chaithr45/tt-eeg-afe/design/docs/sheet1.png

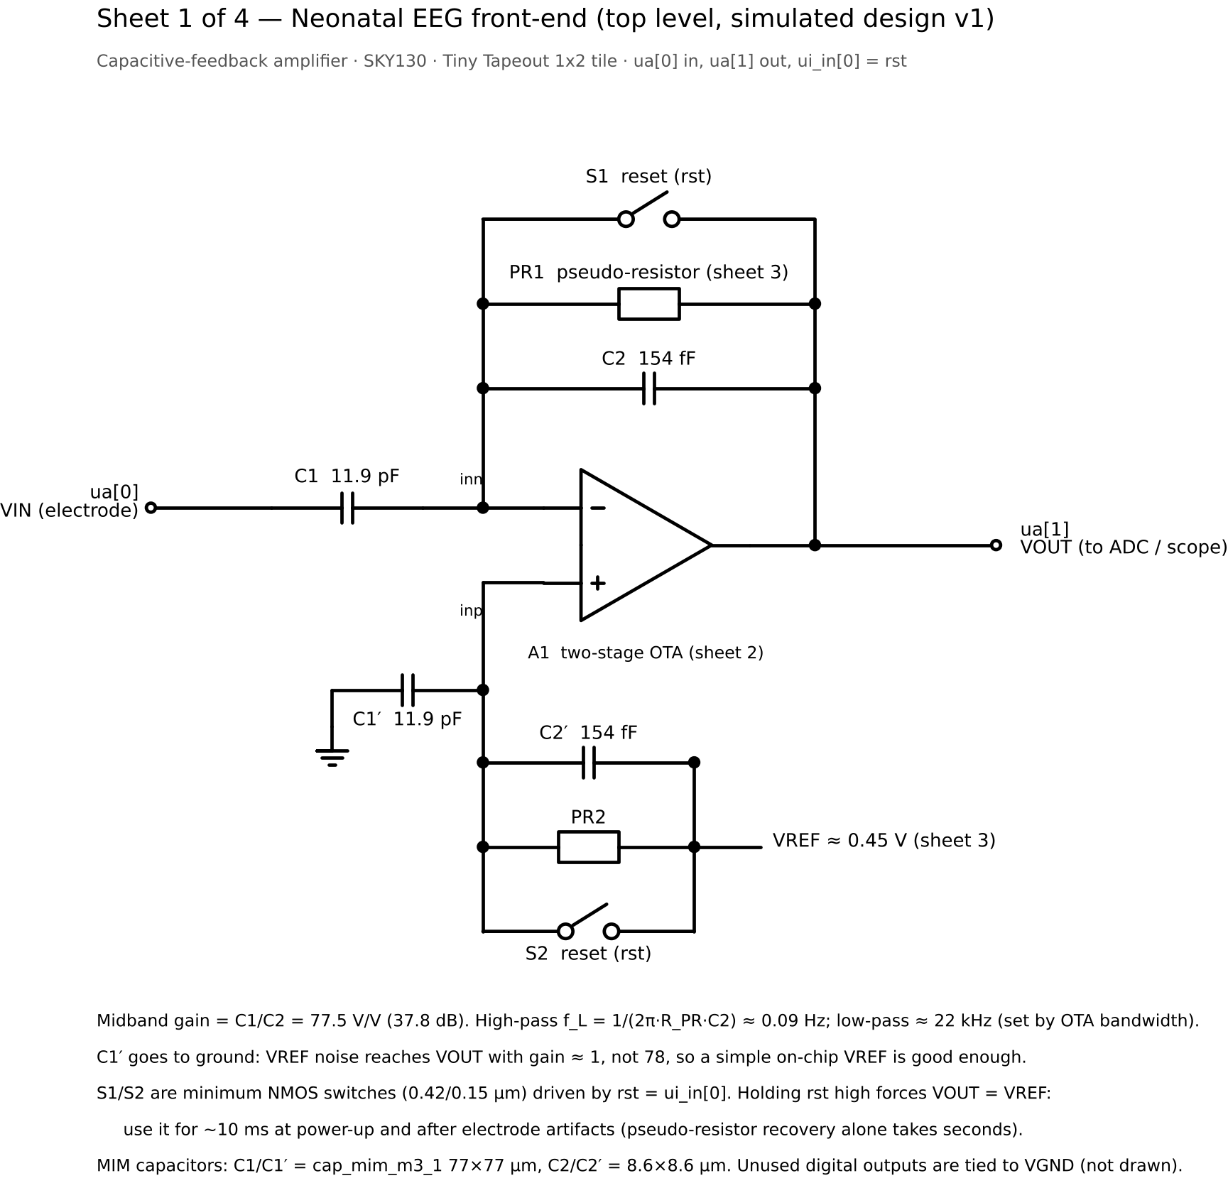
design/docs/sheet1.png
