chaithr45/tt-eeg-afe/design/docs/sheet2.png

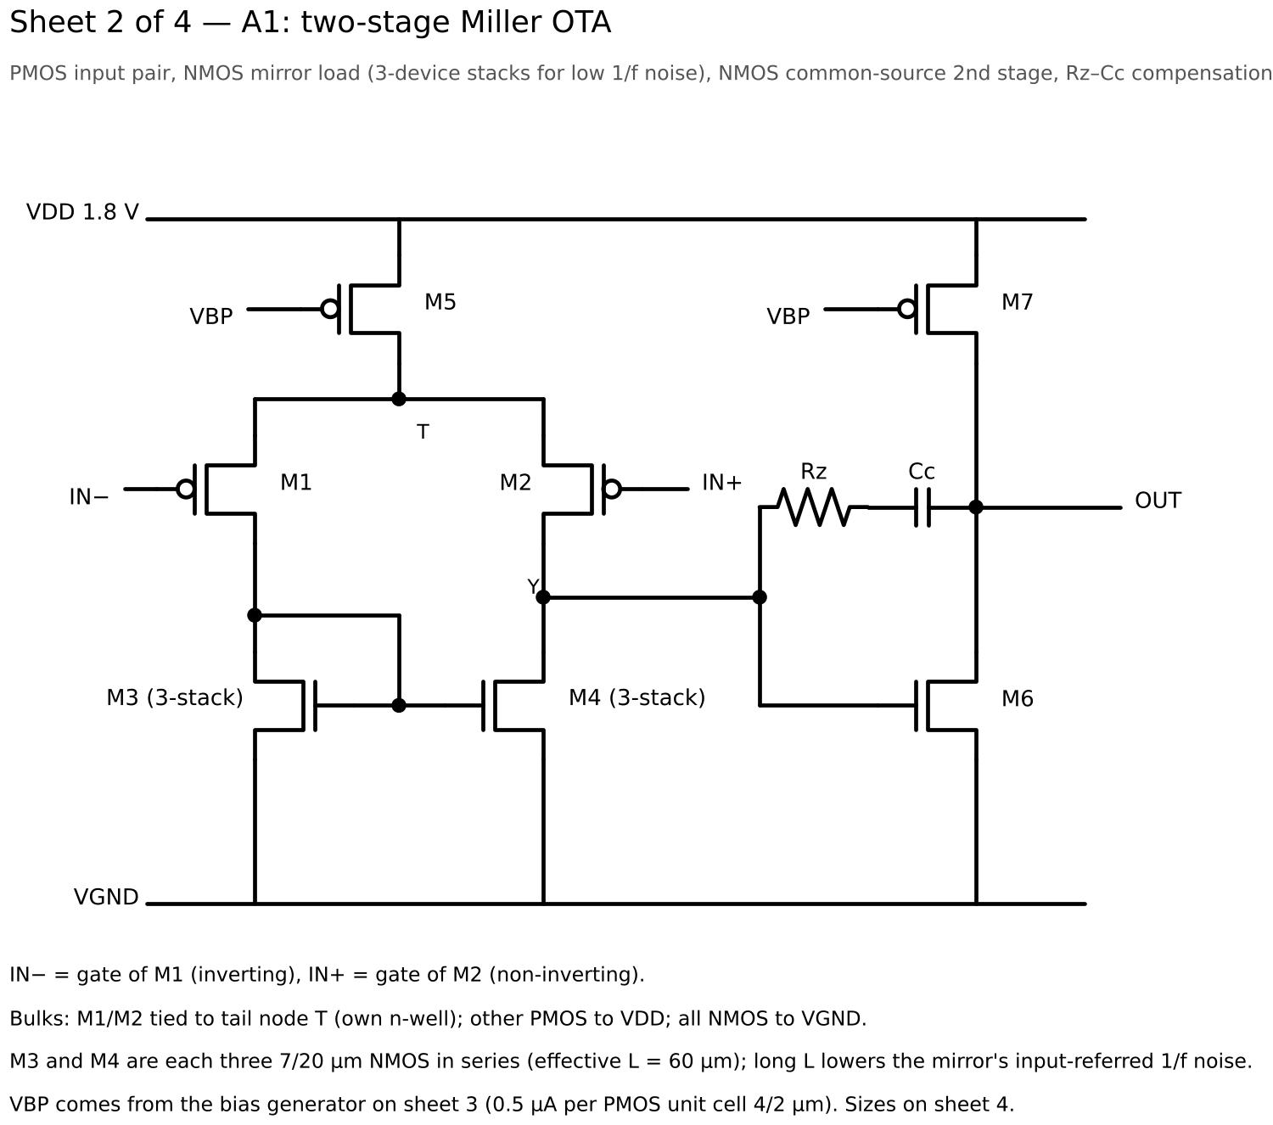
design/docs/sheet2.png
