chaithr45/tt-eeg-afe/design/docs/sheet3.png

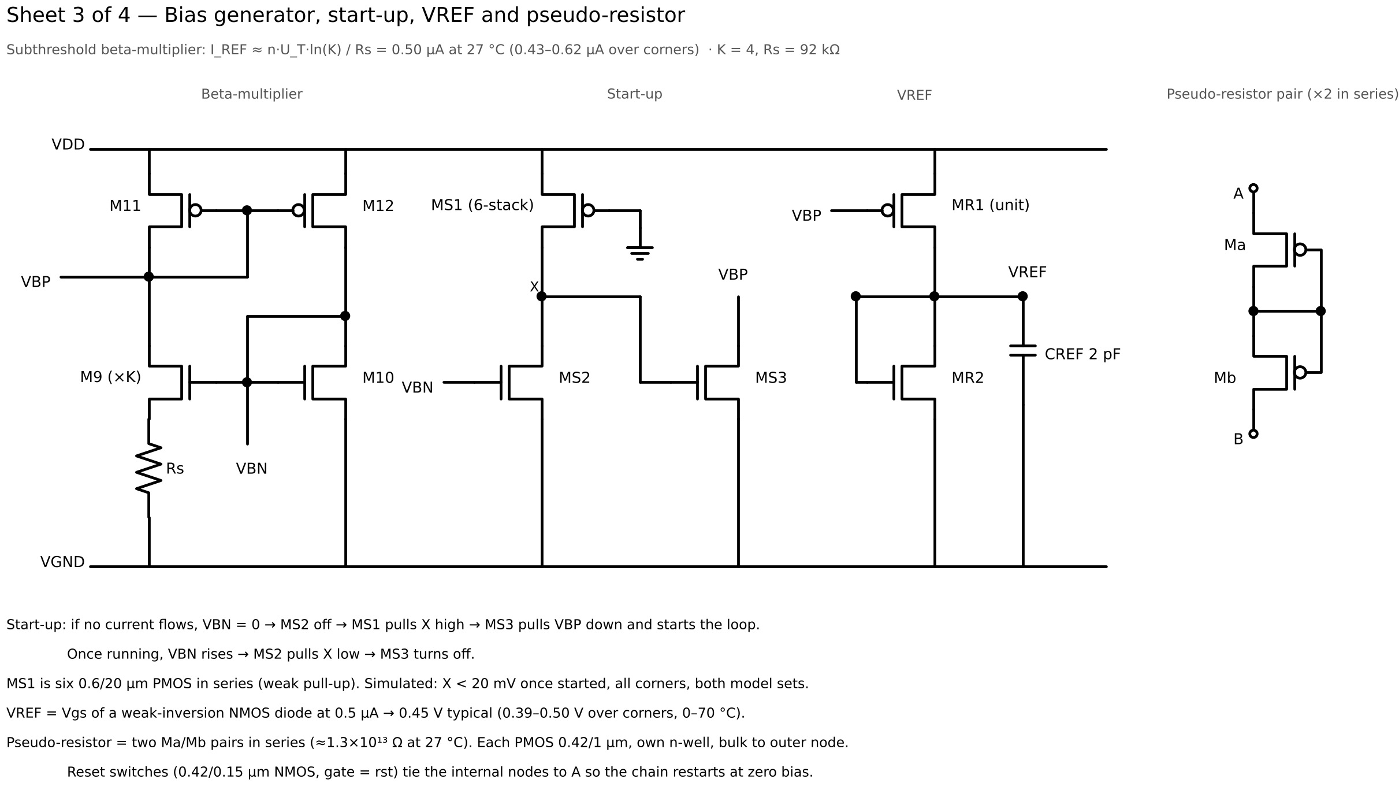
design/docs/sheet3.png
