chaithr45/tt-eeg-afe/design/docs/sheet4.png

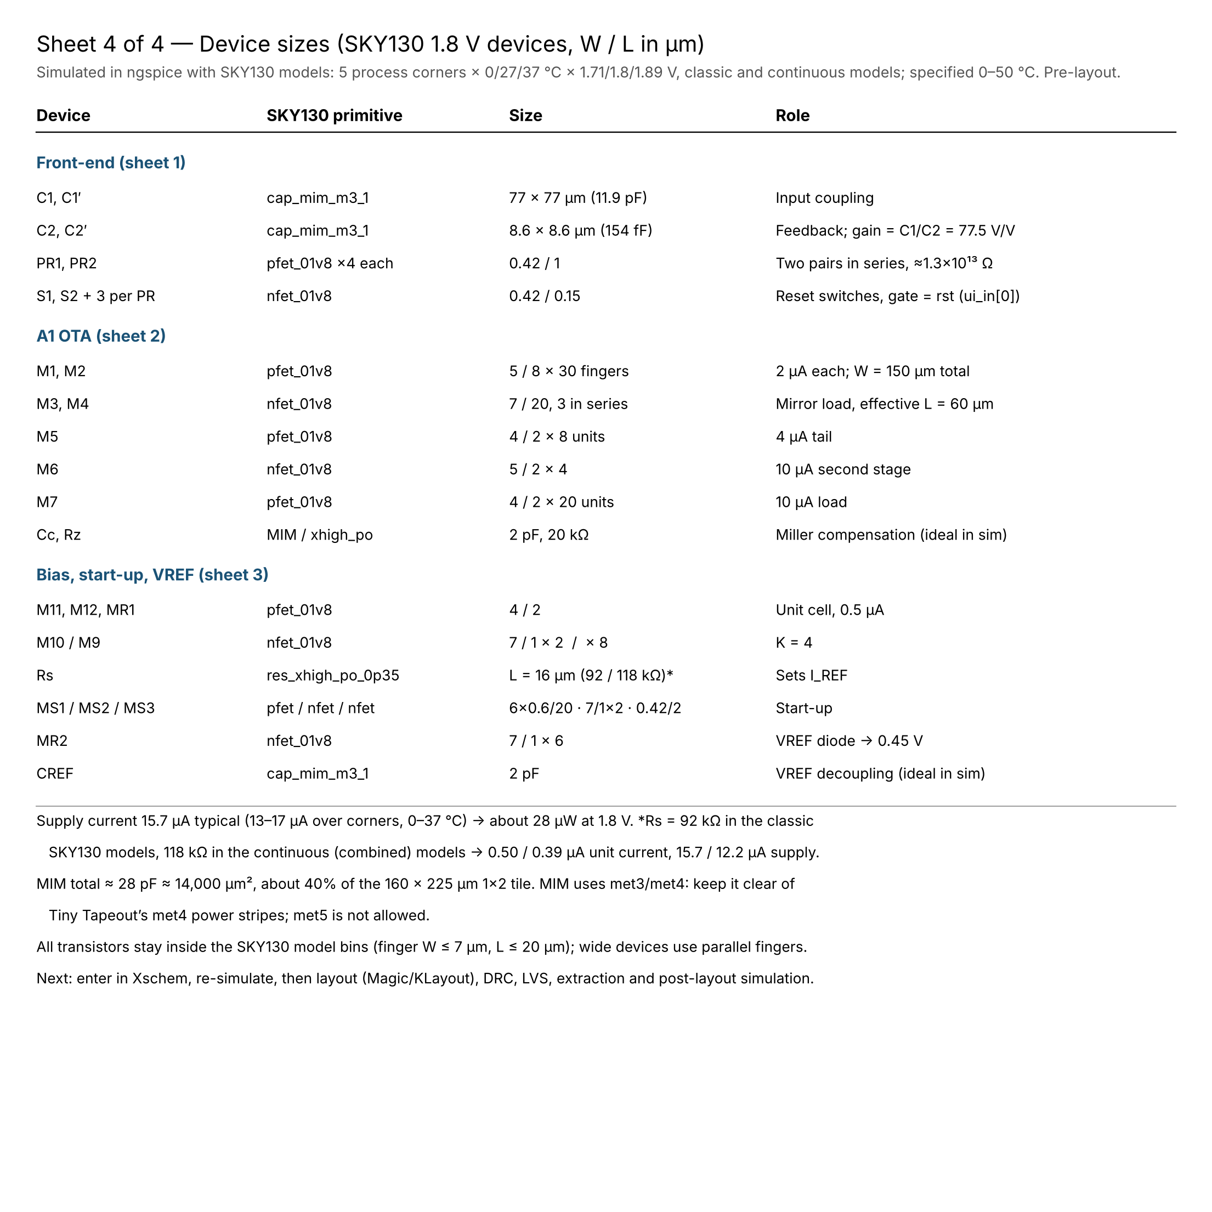
design/docs/sheet4.png
