chaithr45/tt-eeg-afe/design/xschem/img/afe.png

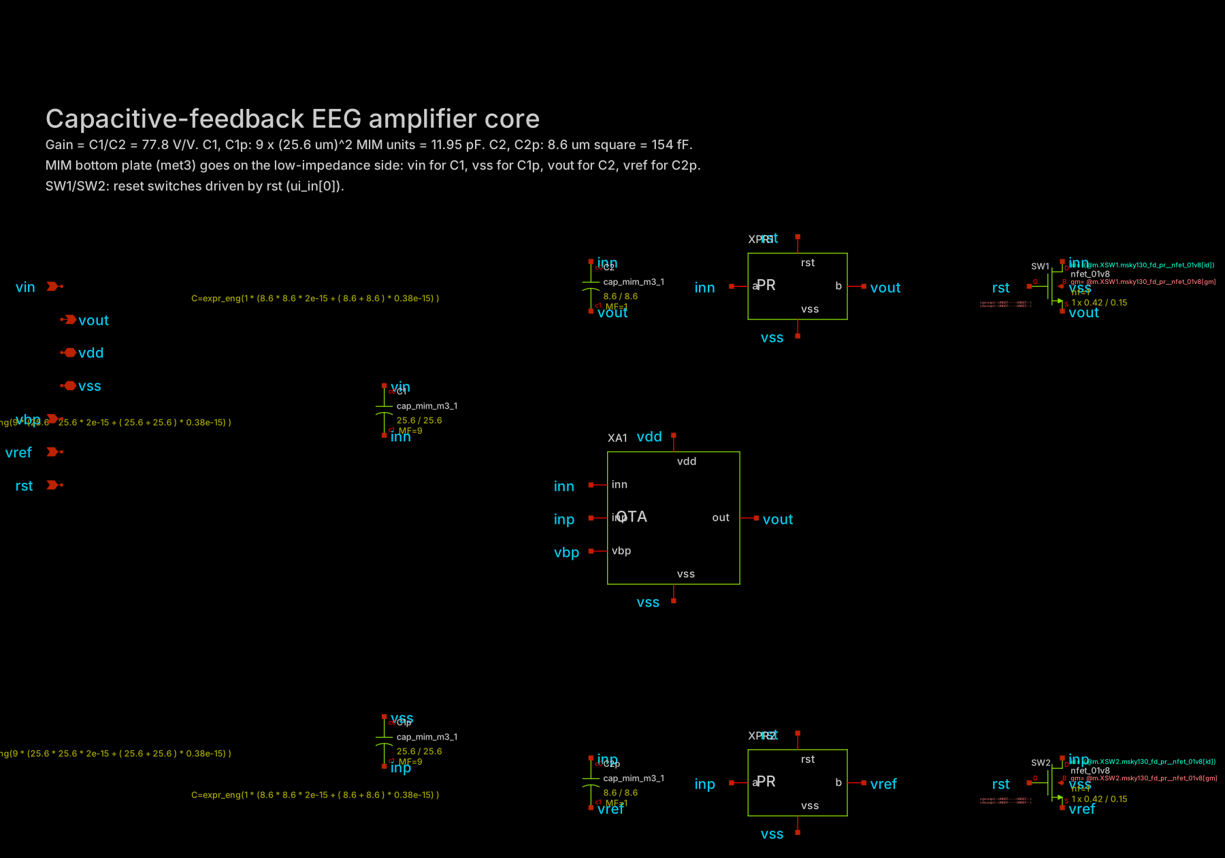
design/xschem/img/afe.png
