chaithr45/tt-eeg-afe/design/xschem/img/bias.png

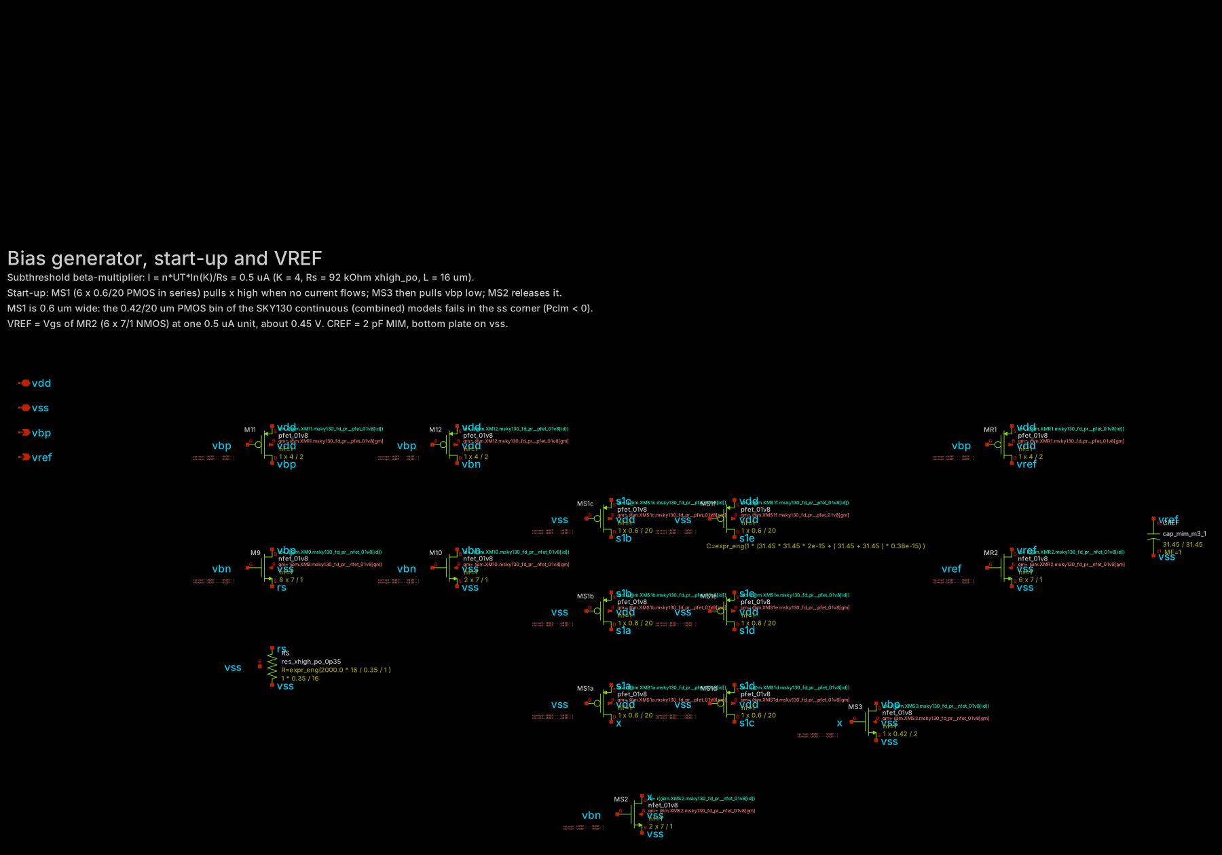
design/xschem/img/bias.png
