chaithr45/tt-eeg-afe/design/xschem/img/eeg_afe_top.png

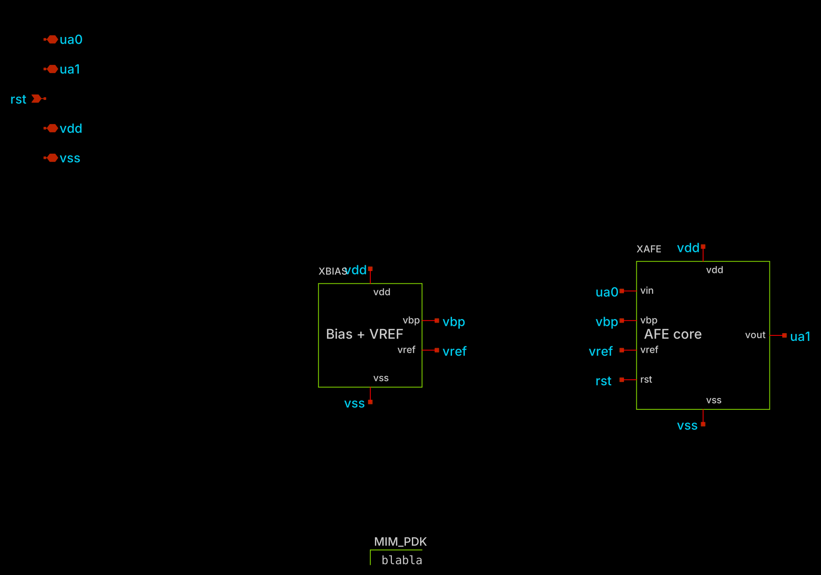
design/xschem/img/eeg_afe_top.png
