chaithr45/tt-eeg-afe/design/xschem/img/ota.png

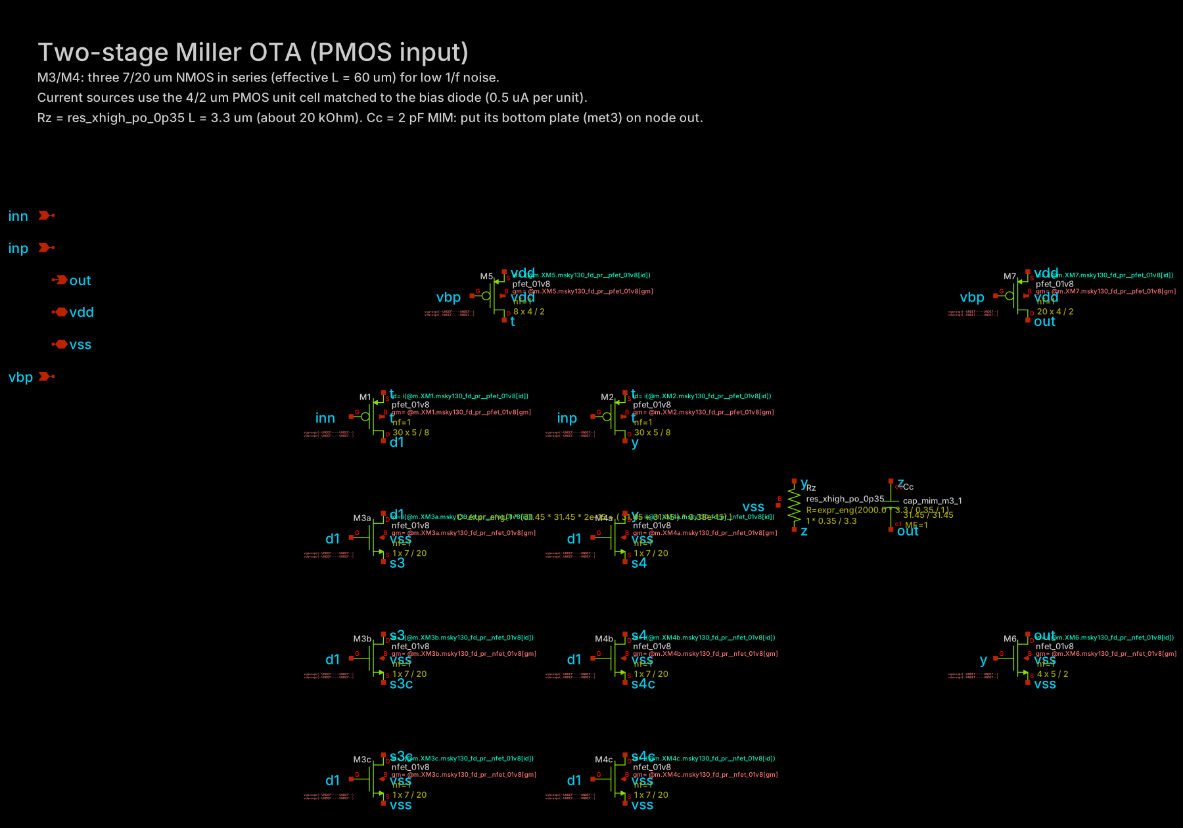
design/xschem/img/ota.png
