chaithr45/tt-eeg-afe/design/xschem/img/pseudo_r.png

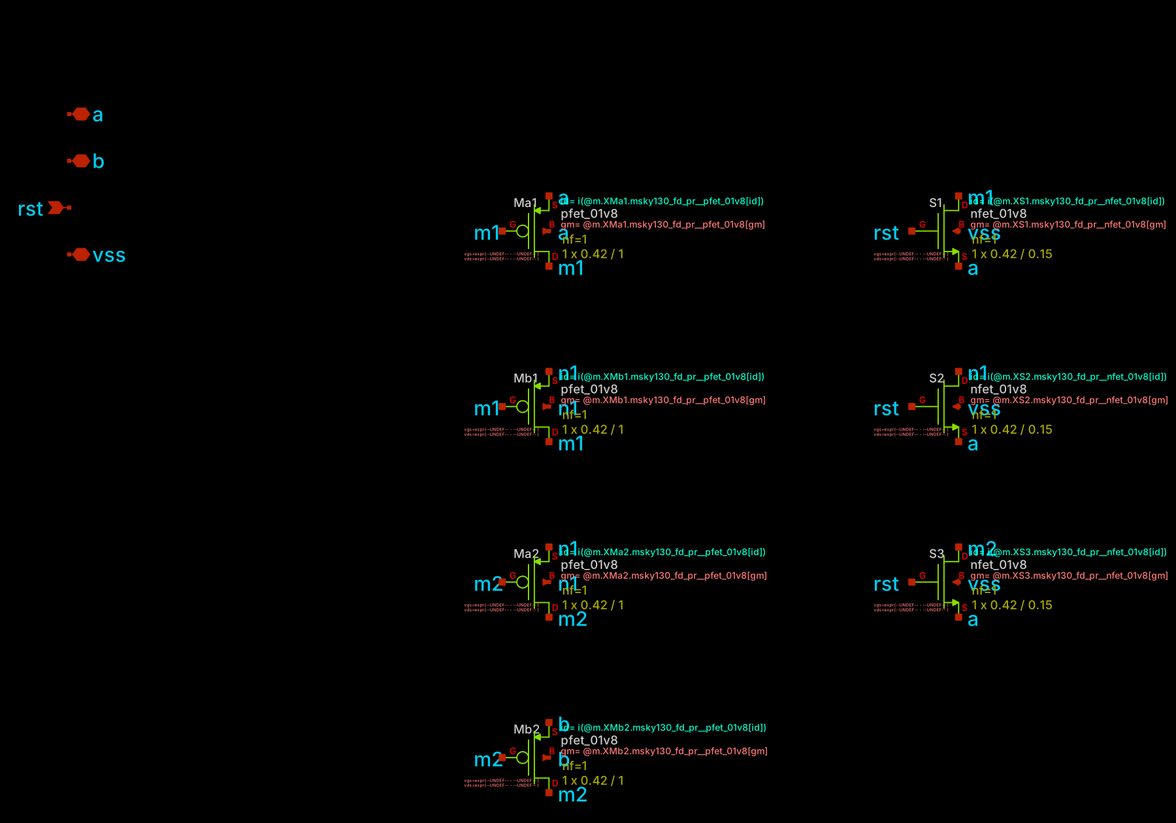
design/xschem/img/pseudo_r.png
