chaithr45/tt-eeg-afe/design/xschem/img/tb_eeg_afe.png

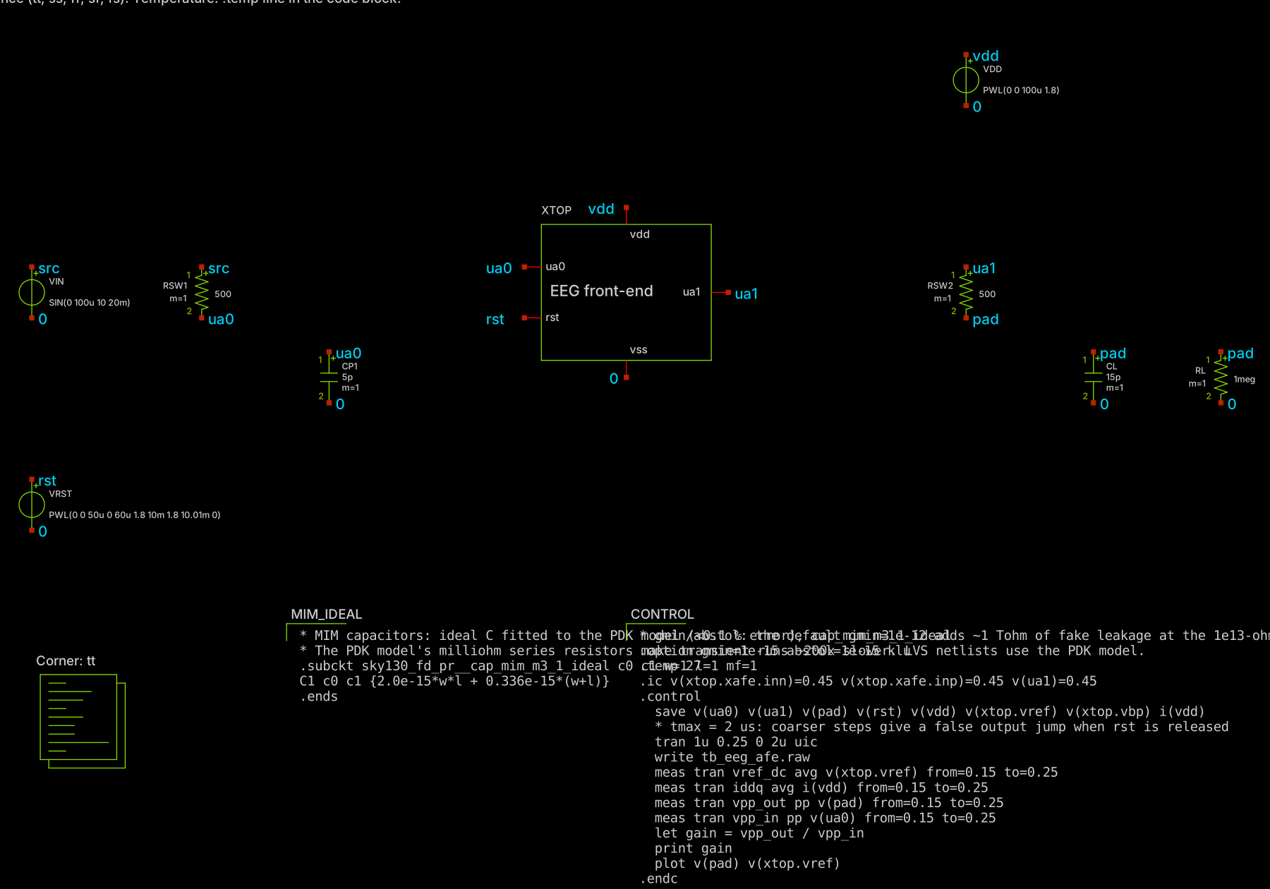
design/xschem/img/tb_eeg_afe.png
