chaithr45/tt-eeg-afe/paper/figs/layout_raw.png

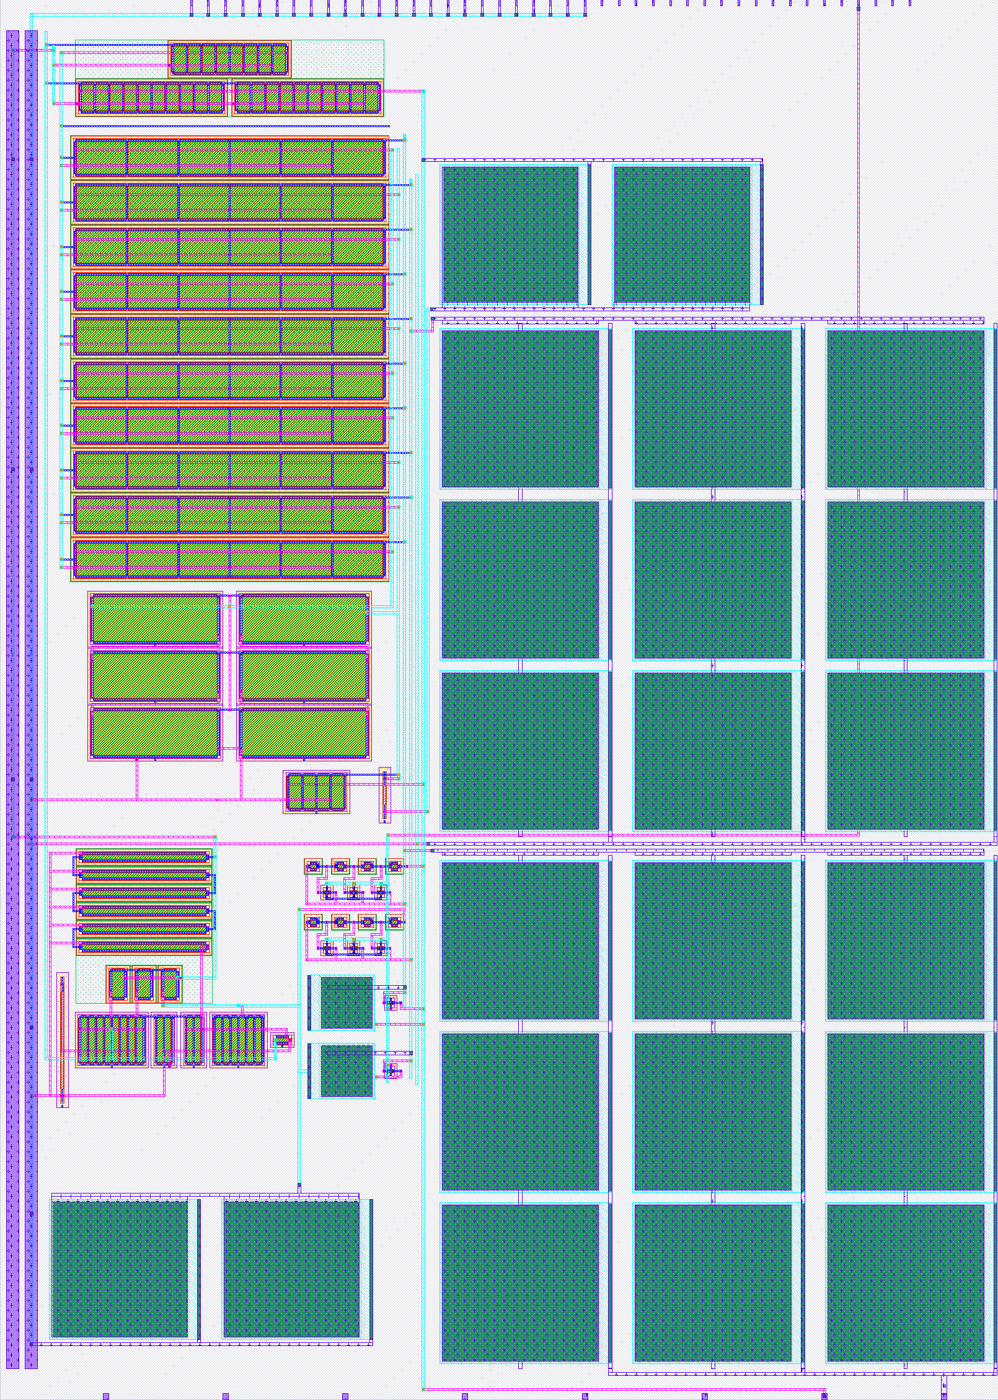
paper/figs/layout_raw.png
