chaithr45/tt-eeg-afe/design/results/fig4_montecarlo.png

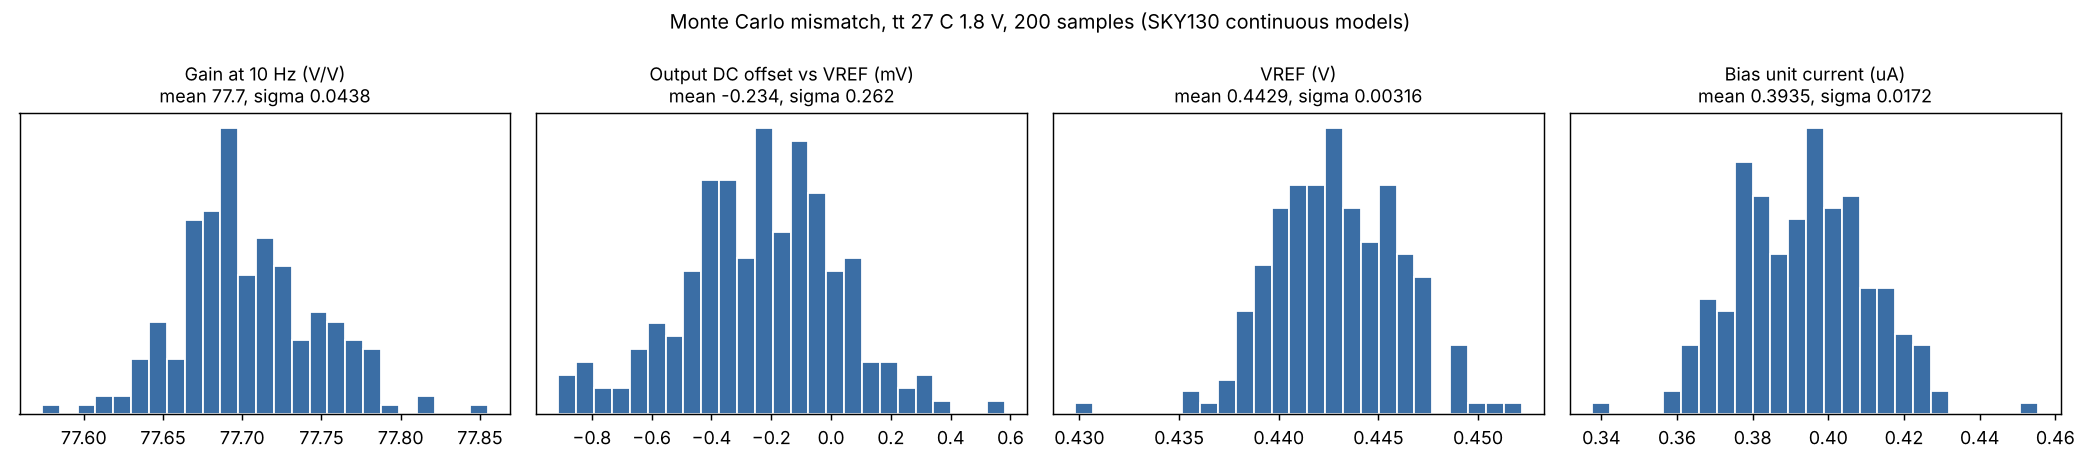
design/results/fig4_montecarlo.png
