chaithr45/tt-eeg-afe/(commit log)

2026-10-22 Layout: scripted Magic flow, device cells, pseudo_r and OTA blocks (DRC clean, LVS match)
    - layout/: Python generators that drive Magic (SKY130 device generator for every
    device, scripted placement and wiring), DRC and Netgen LVS helpers
    - mag/: generated device cells, pseudo_r and ota blocks
    - Cc and CREF split into 2 x 22.25 um MIM units (SKY130 MIM side max is 30 um)
    - xhigh_po resistors get a URPM mask hint (generator's implant was 0.75 um, rule rpm.1 1.27 um)
    - tb_ac.py works with numpy 1.x and 2.x
    Claude-Session: https://claude.ai/code/session_01XQkaUuXt4cuLR8MLQyaF96
    [bias.sch, ota.sch]
2026-10-22 Full layout: bias, top-level core and Tiny Tapeout tile (DRC clean, LVS match, local precheck passes)
    - layout/blk_bias.py, blk_core.py, blk_top.py, lvs_core.py: bias block, complete core in tile
    coordinates (MIM column, gutter trunks, power trunks), Tiny Tapeout top cell with pins,
    VDPWR/VGND stripes and unused outputs tied to VGND
    - Core LVS against the Xschem schematic: circuits match uniquely
    - gds/ and lef/ regenerated from the real layout; official tt precheck passes locally
    - Schematic: C1/C1' pins swapped so the MIM bottom plate (c1, met3) sits on vin/vss as drawn
    Claude-Session: https://claude.ai/code/session_01XQkaUuXt4cu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
    [afe.sch]
2026-10-22 Layout rev B: fixes found by post-layout simulation; top-level LVS; one-shot build
    Post-layout simulation of the first full layout (fdd1f09) showed two parasitic problems:
    - gain 0.56 dB high: the vout trunk ran 1 um from the non-inverting input over ~150 um
    (positive feedback ~7 % of C2). A vss shield track now runs between the inp and vout
    trunks (OTA right-side risers moved 1 um left to make room).
    - PSRR at 50 Hz 77 dB instead of 96 dB (classic models): vdd / vbp coupled onto inn from the
    M7 row. 1.5 um more space plus a metal1 shield on the tail node t between the rows.
    Rev B: gain within 0.05 dB of the schematic, bandwidth back to the schematic value, PSRR
    86 dB (classic) / 90 d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
2026-10-22 Post-layout results, layout picture and updated documentation
    Extracted layout (rev B) against the schematic, both model sets, tt/ss/ff/sf/fs at 27 C and
    tt at 0 / 50 C: gain 37.75-37.76 dB (schematic 37.79), noise within 0.03 uVrms, same supply
    current and output level, PSRR at 50 Hz 81-91 dB, 10 Hz tone 77.2 V/V with the MOS
    pseudo-resistors, output step at reset release ~1 mV.
    - results/postlayout*.json, fig5_postlayout.png
    - docs/layout.png in the README and the datasheet (docs/info.md, docs check passes)
    - design/README.md section 9 (layout checks, post-layout table, what changed and why)
    - IMPLEMENTATION_GUIDE.md steps 4-6 describe the scripted layout flow; what is left is the
    submi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
2026-10-23 Paper: corrections from a number check against the source results
    - NEF ~10 is explained by current split (4 of 15.7 uA in the input pair),
    not by bandwidth
    - band-edge CMRR with f_L spread is ~14 dB at 0.5 Hz (magnitude and phase),
    not 30 dB; midband 62 dB marked as within-die mismatch only
    - 1x2 tile, f_L given as <0.15 Hz everywhere, f_L row limited to the
    pseudo-resistor simulation, PSRR residual stated in Table I
    - status wording: detector 'implemented in' the PL, halves not yet connected
    - FIFO placed in the PL, coupling split 8 + 4 fF, feature-definition and
    robustness claims matched to the detector paper
    Claude-Session: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
